albert21martins/Tablet-paino-keyboard/fotos/20151105_152024.jpg

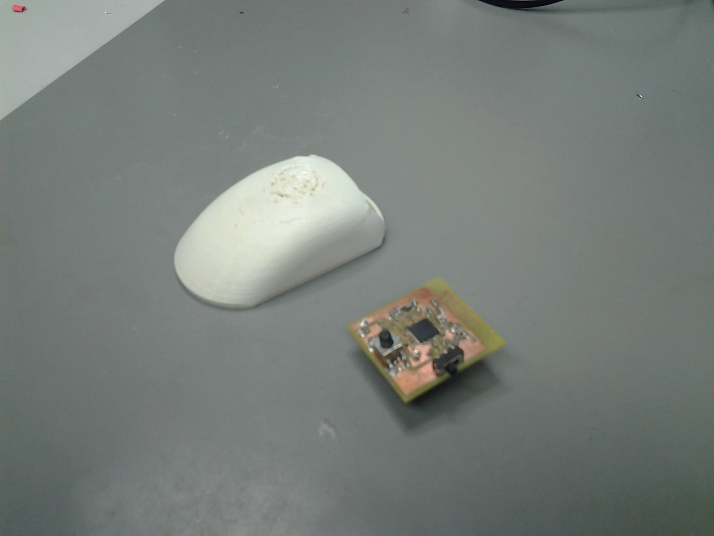
fotos/20151105_152024.jpg
