albert21martins/Tablet-paino-keyboard/fotos/polsador_bottom.jpg

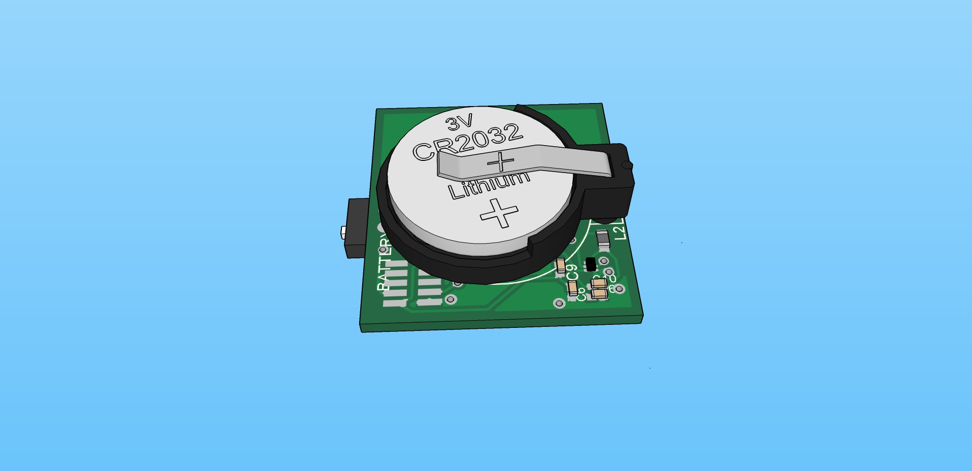
fotos/polsador_bottom.jpg
