albert21martins/Tablet-paino-keyboard/README.md

# Tablet-paino-keyboard
Bluetooth Low Energy 1- button Keyboard controller for Tablets.
