albert21martins/Tablet-paino-keyboard/fotos/20151105_145753.jpg

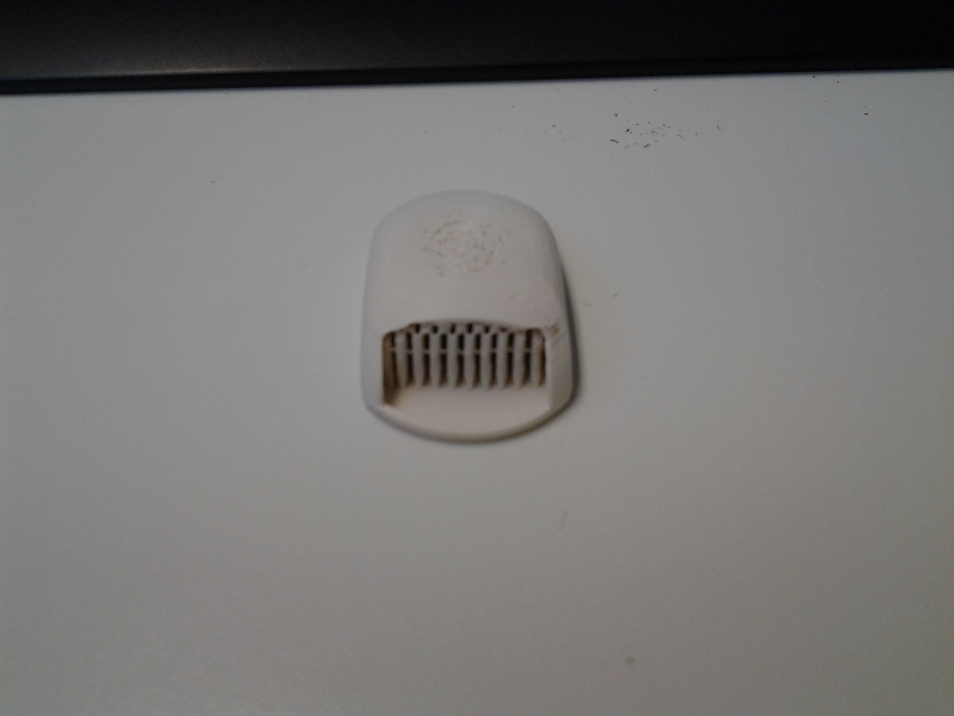
fotos/20151105_145753.jpg
