albert21martins/Tablet-paino-keyboard/fotos/polsador_ISO (1).jpg

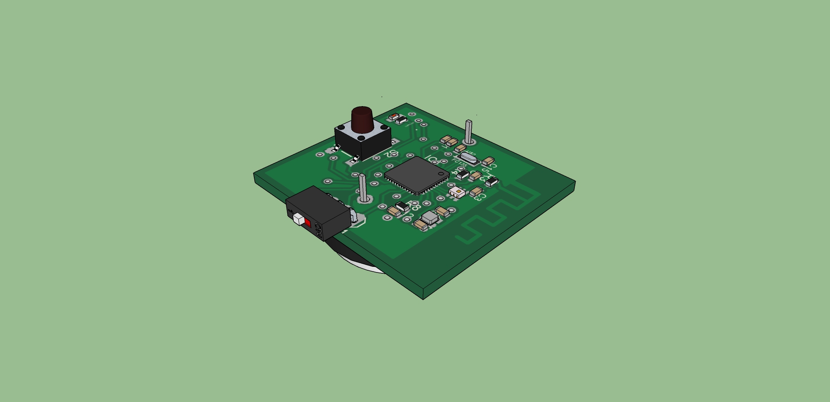
fotos/polsador_ISO (1).jpg
