albert21martins/Tablet-paino-keyboard/fotos/polsadortop.jpg

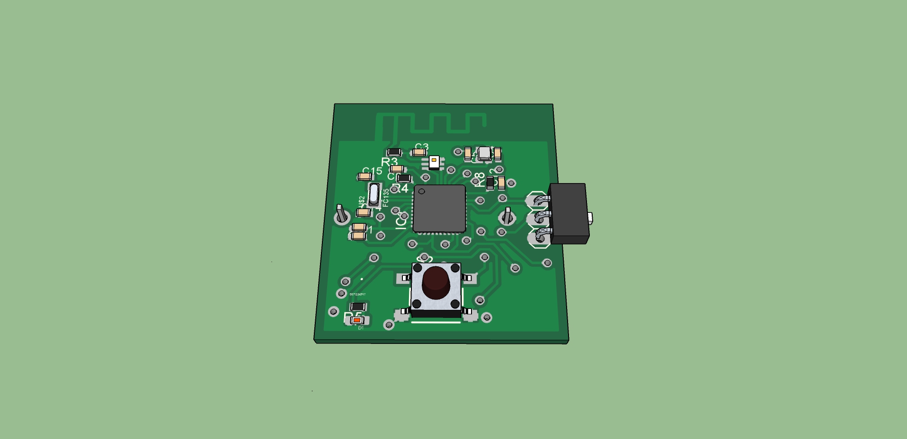
fotos/polsadortop.jpg
