albert21martins/Tablet-paino-keyboard/components/lista_compra.xlsx

 |  |  | this is just a reference, not necesary to be ordere there
Name | Description | value | Available
BATTERY_1 | Battery holderCR2032 |  | http://imall.iteadstudio.com/power/battery/battery-holder/im120803016.html
JP1 | On/Off switch |  | http://www.homeatswift.com/slide-switches/840480.html | this kind of connector (cheapest)
U$4 | TPS62730. DC/DC Buck converter |  | http://www.ti.com/product/tps62730
L2 | Inductor 0805,+-30% | 2.2µH
C10 | Capacitor, 0402, +-20%, 6.3V | 2.2µF
C16 | Capacitor, 0402, +-20%, 6.3V | 2.2µF
C9 | Emi filtered bead,0402 1k ohms Tape GHz Band |  | http://search.murata.co.jp/Ceramy/image/img/PDF/CHN/L0110S0101BLM15H.pdf
R5 | resistor, 0402, | 270Ω
D1 | led red, 0603
S2 | (momentary switch) smd 4 pin button switch |  | http://ecx.images-amazon.com/images/I/41BNQKSRBlL._SY300_.jpg
R8 | resistor, 0402, | 2,7kΩ
c12 | Capacitor, 0402, +-20%, 6.3V | 1nF
c4 | Capacitor, 0402, +-20%, 6.3V | 12pF
c5 | Capacitor, 0402, +-20%, 6.3V | 12pF
U$3 | crystal 32MHz, 10pF, 2x1.6m,FA-128, +- 10ppm |  | http://de.farnell.com/abracon/abm11-32-000mhz-d2x-t3/quarz-32mhz-10pf-2-x-1-6mm/dp/2467781?MER=i-9b10-00002068
F1 filter | 2.45 GHz Impedance Matched Balun-Filter |  | http://www.farnell.com/datasheets/1678468.pdf
R3 | resistor, 0402, | 0Ω
C3 | Capacitor, 0402, +-20%, 6.3V | 0,5pF
R4 | resistor, 0402, | 56kΩ
C6 | Capacitor, 0402, +-20%, 6.3V | 100nF
C7 | Capacitor, 0402, +-20%, 6.3V | 100nF
C8 | Capacitor, 0402, +-20%, 6.3V | 100nF
C14 | Capacitor, 0402, +-20%, 6.3V | 15pF
C15 | Capacitor, 0402, +-20%, 6.3V | 15pF
U$2 | Crystal 32.768Khz, FC-12M, 12,5pF
IC1 | CC2540F128RHAT or CC2540F256RHAT (cheapest) |  | http://www.ti.com/product/cc2540
C11 | Capacitor, 0402, +-20%, 6.3V | 1µF
