albert21martins/Tablet-paino-keyboard/box-design/paino.SLDPRT

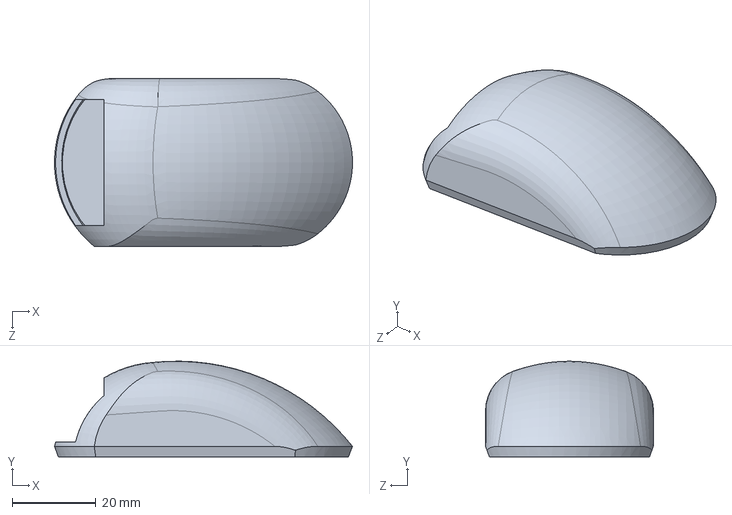
[picture p7: CAD file, 2015-11-07]
box-design/paino.SLDPRT
71.0 x 22.8 x 40.0 mm
