albert21martins/Tablet-paino-keyboard/(list of files, cad)

Other CAD files:
box-design/paino.STL
