albert21martins/Tablet-paino-keyboard/eagle/Polsador .brd

## EAGLE design eagle/Polsador .brd (2015-11-07)

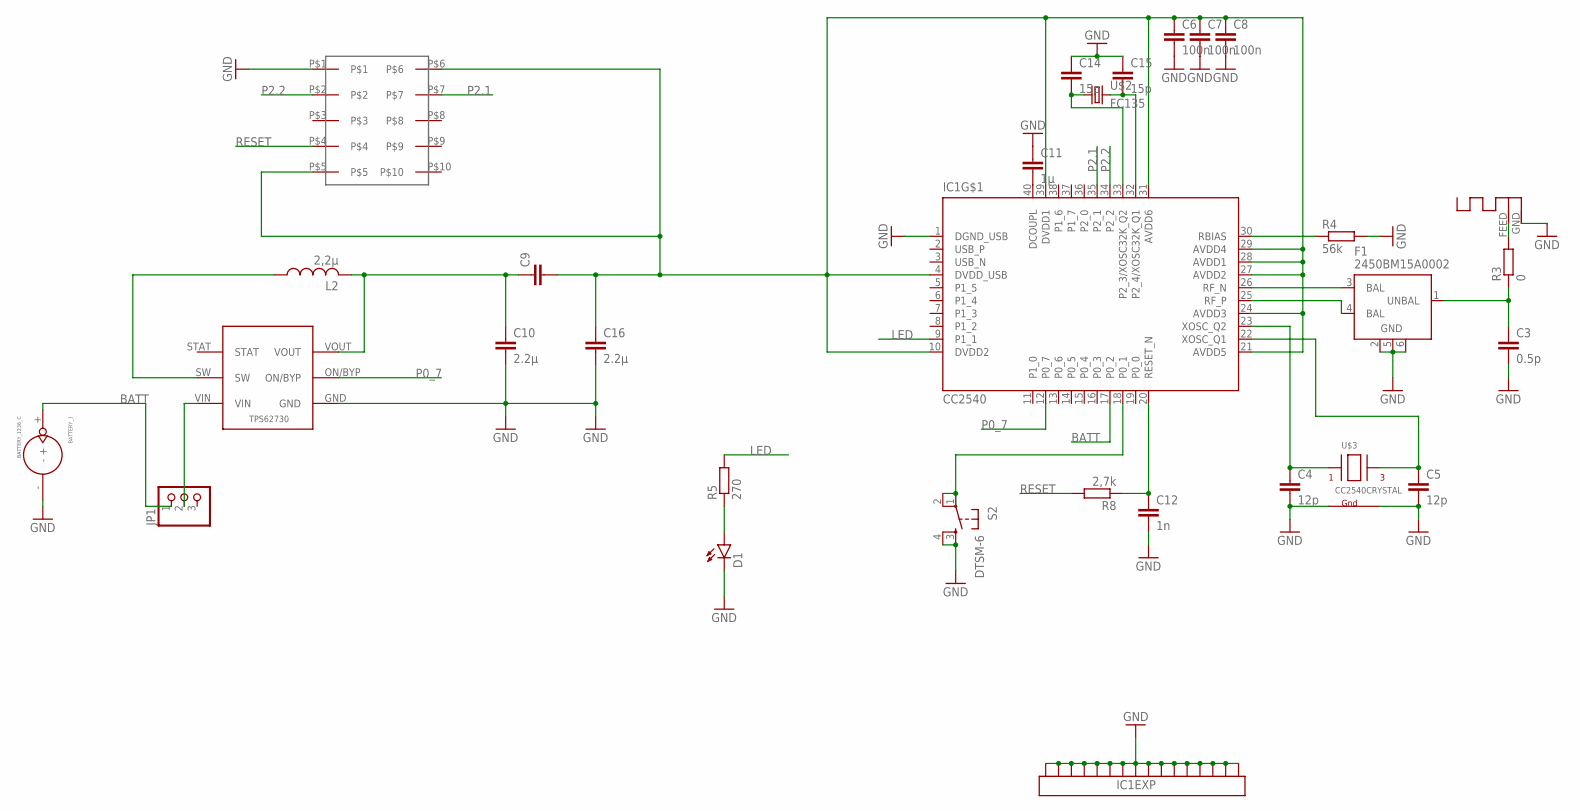
[picture p8: schematic Polsador .sch]

Parts:
ANT1: ANTENNA; RN-ANT
BATTERY_1: BATTERY_1236_C
C3: 0.5p; C0402K
C4, C5: 12p; C0402K
C6, C7, C8: 100n; C0402K
C9: C-EUC0402; C0402
C10, C16: 2.2µ; C0402K
C11: 1µ; C0402K
C12: 1n; C0402K
C14, C15: 15p; C0402K
D1: LED0603; LED-0603
F1: 2450BM15A0002
IC1: CC2540; QFN40-6X6
JP1: PINHD-1X3; 1X03
L2: 2,2µ; L2012C
R3: 0; R0402
R4: 56k; R0402
R5: 270; R0402
R8: 2,7k; R0402
S2: DTSM-6
U$1: DEBUG
U$2: FC135
U$3: CC2540CRYSTAL
U$4: TPS62730

Connections:
BATT: BATTERY_1.+, IC1.17 (P0_2), JP1.1
GND: ANT1.GND, BATTERY_1.-, C3.2, C4.2, C5.2, C6.2, C7.2, C8.2, C10.2, C11.1, C12.2, C14.1, C15.1, C16.2, D1.C, F1.2 (GND), F1.5 (GND), F1.6 (GND), IC1.1 (DGND_USB), IC1.EXP@1 (EXP16), IC1.EXP@2 (EXP16), IC1.EXP@3 (EXP16), IC1.EXP@4 (EXP16), IC1.EXP@5 (EXP16), IC1.EXP@6 (EXP16), IC1.EXP@7 (EXP16), IC1.EXP@8 (EXP16), IC1.EXP@9 (EXP16), IC1.EXP@10 (EXP16), IC1.EXP@11 (EXP16), IC1.EXP@12 (EXP16), IC1.EXP@13 (EXP16), IC1.EXP@14 (EXP16), IC1.EXP@15 (EXP16), IC1.EXP@16 (EXP16), R4.2, S2.3, S2.4, U$1.P$1, U$3.2 (G1), U$3.4 (G2), U$4.GND
LED: IC1.9 (P1_1), R5.2
unnamed: C14.2, IC1.33 (P2_3/XOSC32K_Q2), U$2.1
unnamed: C15.2, IC1.32 (P2_4/XOSC32K_Q1), U$2.2
unnamed: IC1.18 (P0_1), S2.1, S2.2
unnamed: L2.1, U$4.SW
unnamed: C9.1, C10.1, L2.2, U$4.VOUT
unnamed: C4.1, IC1.23 (XOSC_Q2), U$3.1 (X1)
unnamed: F1.3 (BAL), IC1.26 (RF_N)
unnamed: F1.4 (BAL), IC1.25 (RF_P)
unnamed: C3.1, F1.1 (UNBAL), R3.1
unnamed: ANT1.FEED, R3.2
unnamed: C5.1, IC1.22 (XOSC_Q1), U$3.3 (X2)
unnamed: IC1.30 (RBIAS), R4.1
unnamed: C11.2, IC1.40 (DCOUPL)
unnamed: C12.1, IC1.20 (RESET_N), R8.1
unnamed: C6.1, C7.1, C8.1, C9.2, C16.1, IC1.4 (DVDD_USB), IC1.10 (DVDD2), IC1.21 (AVDD5), IC1.24 (AVDD3), IC1.27 (AVDD2), IC1.28 (AVDD1), IC1.29 (AVDD4), IC1.31 (AVDD6), IC1.39 (DVDD1), U$1.P$5, U$1.P$6
unnamed: JP1.2, U$4.VIN
unnamed: D1.A, R5.1
P0_7: IC1.12 (P0_7), U$4.ON/BYP
P2.1: IC1.35 (P2_1), U$1.P$7
P2.2: IC1.34 (P2_2), U$1.P$2
RESET: R8.2, U$1.P$4

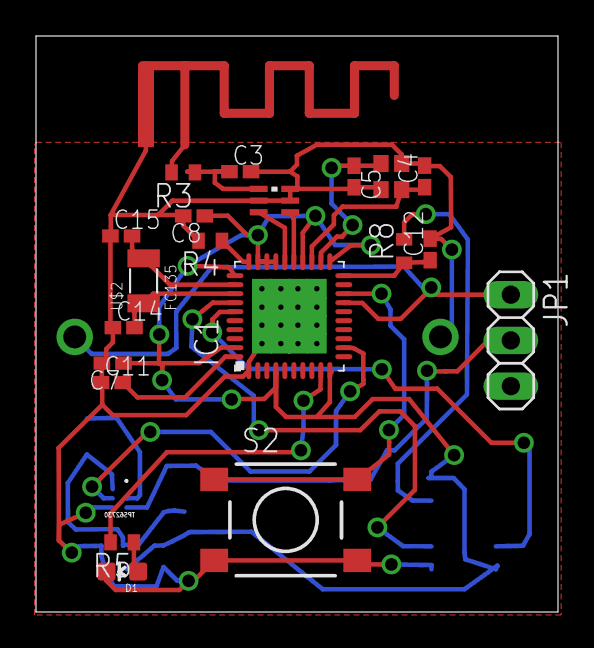
[picture p9: board Polsador .brd from above]

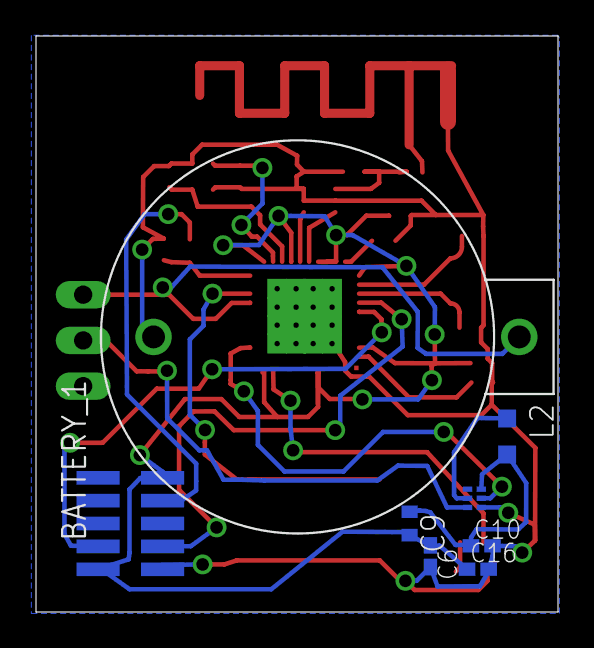
[picture p10: board Polsador .brd from below]

Board: 2 copper layers, 29.0 x 32.0 mm, 29 parts (8 on the bottom side), 24 nets.
